adafruit/Adafruit-NeoKey-Snap-Apart-PCB/README.md

## Adafruit NeoKey Snap-Apart 5x6 Ortho Mechanical Key Switches with NeoPixel PCB

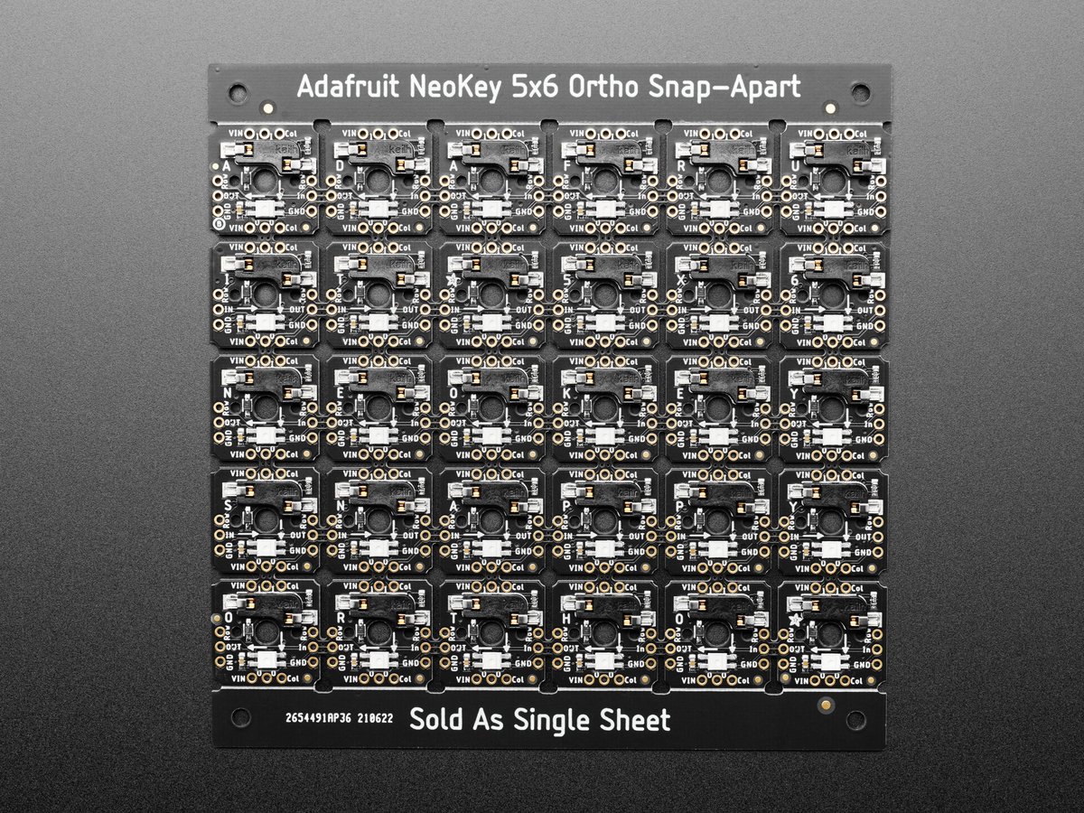
[picture p1: assets/5157.jpg]
<a href="http://www.adafruit.com/products/5157"><br/>
Click here to purchase one from the Adafruit shop</a>

PCB files for the Adafruit NeoKey Snap-Apart 5x6 Ortho Mechanical Key Switches with NeoPixel. 

Format is EagleCAD schematic and board layout
* https://www.adafruit.com/product/5157

### Description

For folks who want ready-to-go keeb action, we've got the lovely Adafruit Macropad with a 3x4 grid of MX+NeoPixel key switches - but for those who like to forge their own path, we now present the easiest way of creating custom ortholinear (that's a fancy word for gridded) key matrices. Instead of hand soldering together a custom matrix of NeoKey socket breakouts, the Adafruit NeoKey 5x6 Ortho Snap-Apart Mechanical Key Switches with NeoPixel has 30 key switches that can be snapped apart to make any size grid.

That's right! Even though it comes as 5x6, you can turn it into 2x3, 1x6, 4x3...whatever you wish, and it will work just the way you expect. The little break-apart tabs have traces running through them that pass the power, NeoPixel, and keymatrix lines up and down.

Each 'sub-key' is the same - with a column and row line that is diode protected. For whatever grid size you eventually choose, connect a digital IO pin from your microcontroller to each of the outer rows and columns. With the diode, you don't have to worry about key ghosting.

If you want to add glowy goodness, that's even easier. Each key also has a single reverse-mount NeoPixel pointing up through the spot where many switches would have an LED to shine through. Connect 3 to 5V power to any of the + and - pins on the grid, and connect a single digital IO line to the beginning of the 'NeoPixel snake' that winds its way through the matrix. A weak 2.2K pass-through resistor will shunt data through at the end of each row, so you don't have to do any jumpering unless the matrix is not-rectangular.

Every breakout has a Kailh socket, which means you can plug in any MX-compatible switch instead of soldering it in. You may need a little glue to keep the switch in place: hot glue or a dot of epoxy worked fine for us. The sub-keys are spaced 0.75" apart for compact keebing. There's large 0.125" mounting holes at the corners of each key for easy mounting to a backplane.

Please note, each order comes with one sheet of assembled PCBs that can be broken apart - we include top and bottom railing bits to help keep it nice and flat during shipment. Once the grid is broken, you could jumper the breakout pads together to re-connect but it won't be very fun. Mechanical switches and keycaps are not included! Use any MX-compatible switch: Kailh, Gateron, etc all work!

### License

Adafruit invests time and resources providing this open source design, please support Adafruit and open-source hardware by purchasing products from [Adafruit](https://www.adafruit.com)!

Designed by Limor Fried/Ladyada for Adafruit Industries.

Creative Commons Attribution/Share-Alike, all text above must be included in any redistribution. 
See license.txt for additional details.
